MIGT-Lab/respiratory-motion-phantom/docs/images/part_d_chamfer.png

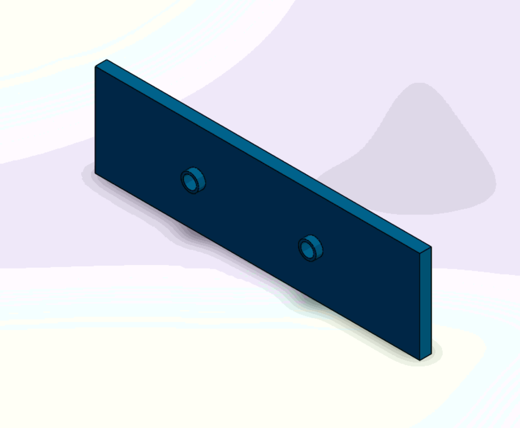
docs/images/part_d_chamfer.png
