MIGT-Lab/respiratory-motion-phantom/hardware/motion-actuator/actuator_b.stl

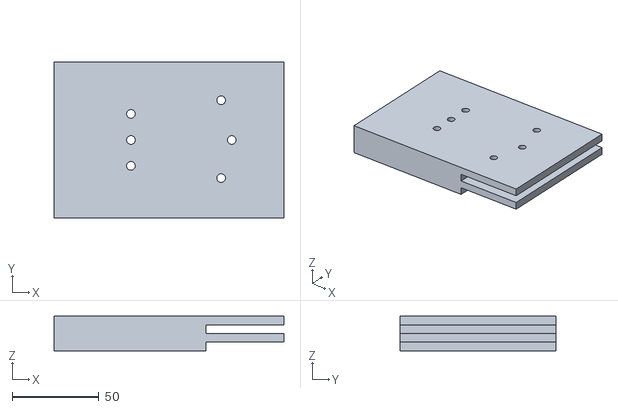
[picture p12: CAD file, 2026-10-25]
hardware/motion-actuator/actuator_b.stl
132.5 x 89.8 x 20.0
