MIGT-Lab/respiratory-motion-phantom/hardware/motion-phantom/back_cover.stl

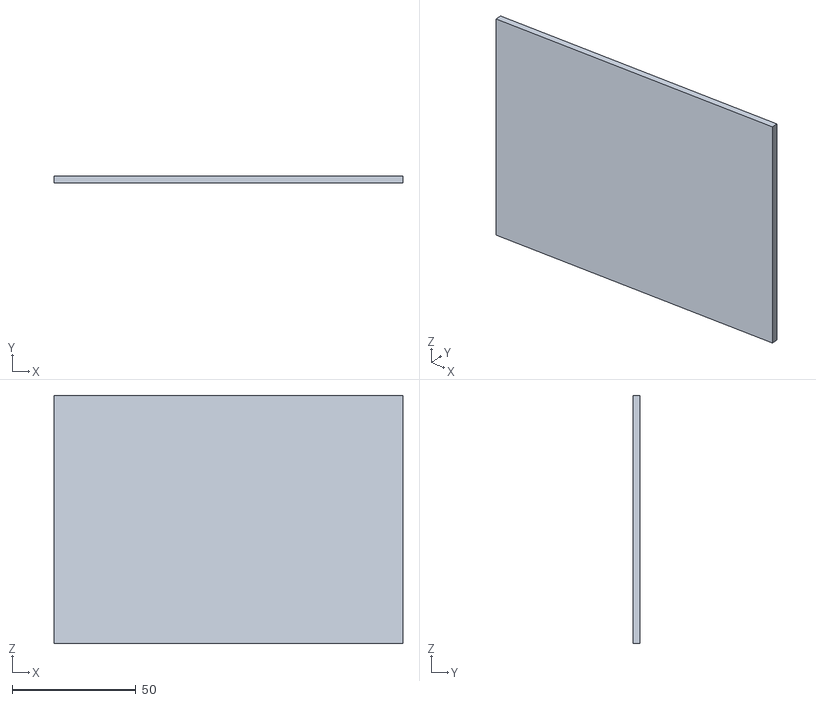
[picture p13: CAD file, 2026-10-25]
hardware/motion-phantom/back_cover.stl
140.8 x 3.00 x 100.2
