MIGT-Lab/respiratory-motion-phantom/hardware/motion-actuator/motor_cover_a.stl

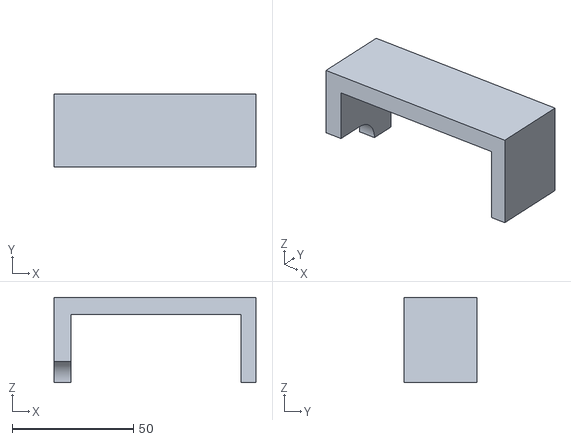
[picture p14: CAD file, 2026-10-25]
hardware/motion-actuator/motor_cover_a.stl
83.4 x 30.0 x 35.1
