MIGT-Lab/respiratory-motion-phantom/hardware/motion-phantom/part_c.stl

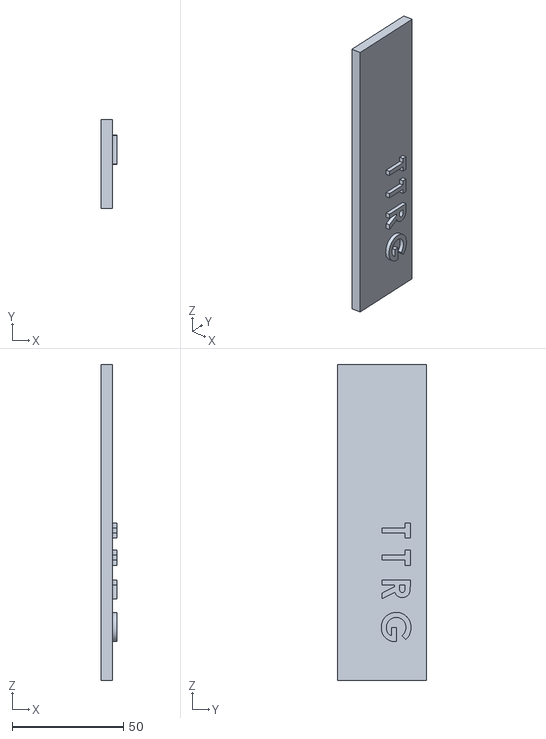
[picture p15: CAD file, 2026-10-25]
hardware/motion-phantom/part_c.stl
7.00 x 40.0 x 142.0
