MIGT-Lab/respiratory-motion-phantom/hardware/motion-actuator/bumper.stl

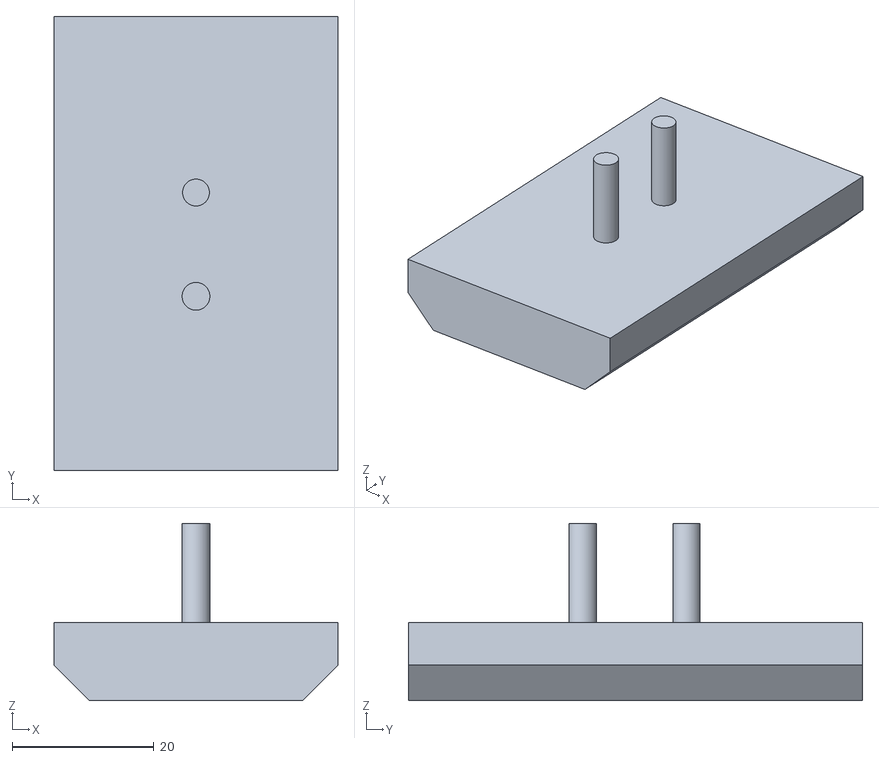
[picture p16: CAD file, 2026-10-25]
hardware/motion-actuator/bumper.stl
40.0 x 64.0 x 25.0
