MIGT-Lab/respiratory-motion-phantom/hardware/motion-phantom/bag_box.stl

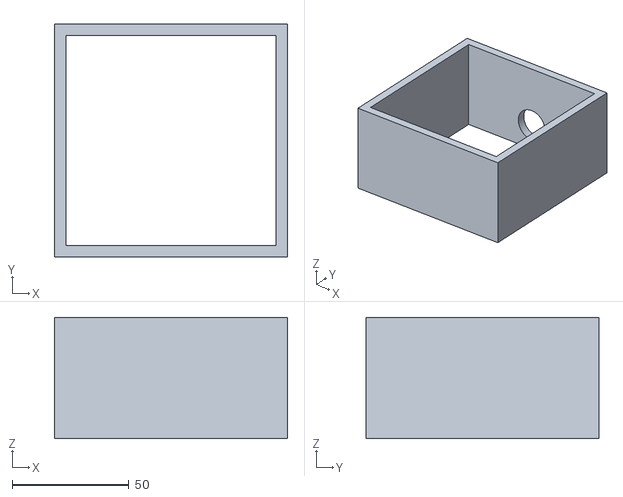
[picture p17: CAD file, 2026-10-25]
hardware/motion-phantom/bag_box.stl
100.0 x 100.0 x 52.0
