MIGT-Lab/respiratory-motion-phantom/hardware/motion-actuator/mcw.stl

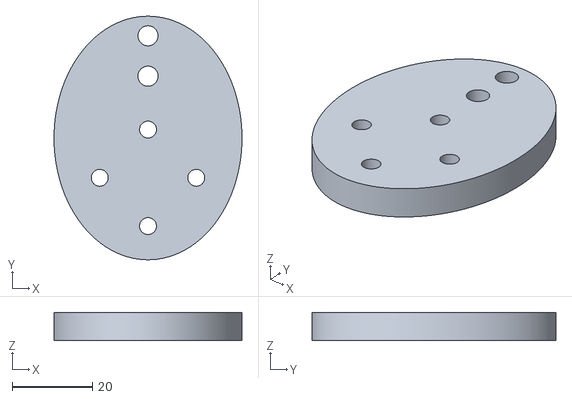
[picture p18: CAD file, 2026-10-25]
hardware/motion-actuator/mcw.stl
46.7 x 60.6 x 7.00
