MIGT-Lab/respiratory-motion-phantom/hardware/motion-phantom/pusher_a.stl

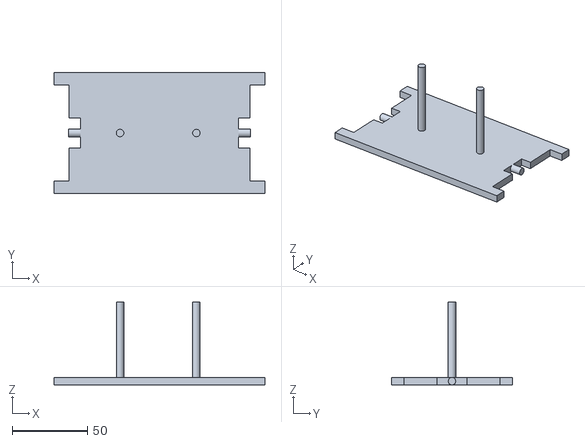
[picture p19: CAD file, 2026-10-25]
hardware/motion-phantom/pusher_a.stl
140.0 x 80.0 x 55.0
