MIGT-Lab/respiratory-motion-phantom/hardware/motion-actuator/piston_holder_b.stl

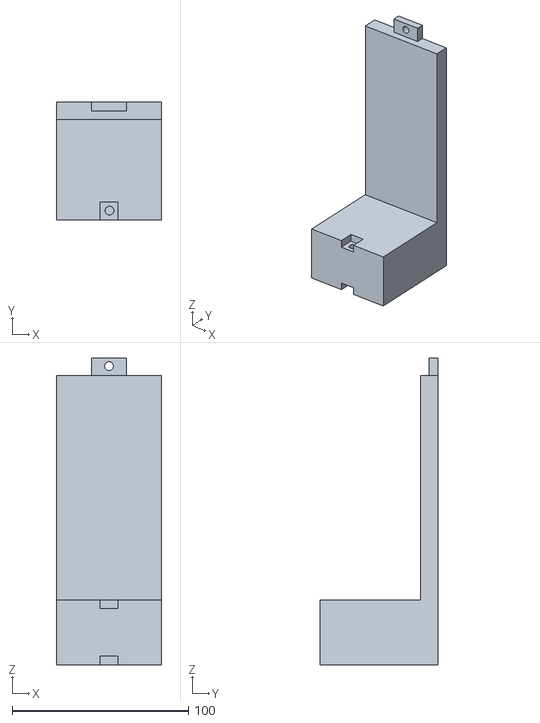
[picture p20: CAD file, 2026-10-25]
hardware/motion-actuator/piston_holder_b.stl
59.4 x 66.9 x 174.4
