MIGT-Lab/respiratory-motion-phantom/hardware/motion-phantom/part_d.stl

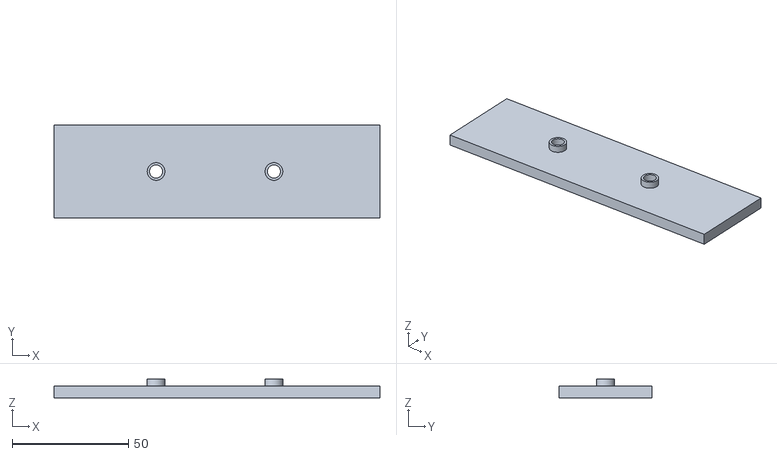
[picture p21: CAD file, 2026-10-25]
hardware/motion-phantom/part_d.stl
140.0 x 40.0 x 8.00
