MIGT-Lab/respiratory-motion-phantom/hardware/motion-phantom/part_b.stl

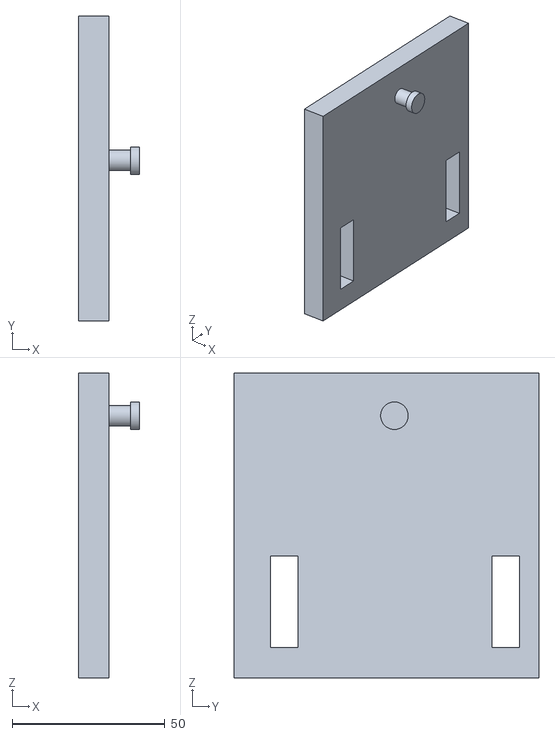
[picture p22: CAD file, 2026-10-25]
hardware/motion-phantom/part_b.stl
20.0 x 100.0 x 100.0
