MIGT-Lab/respiratory-motion-phantom/hardware/motion-actuator/bvm_holder_b.stl

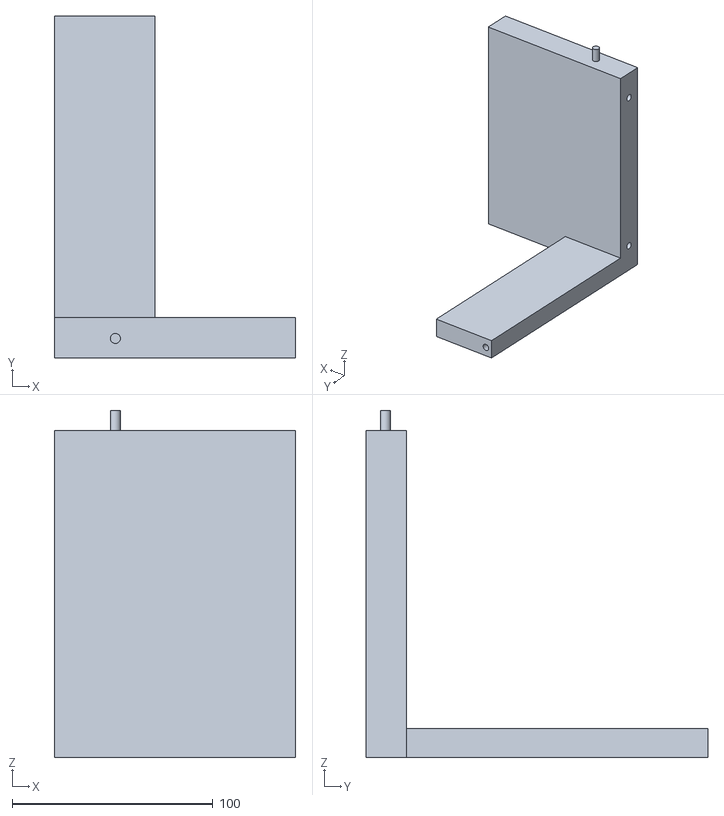
[picture p23: CAD file, 2026-10-25]
hardware/motion-actuator/bvm_holder_b.stl
120.2 x 170.1 x 172.7
