MIGT-Lab/respiratory-motion-phantom/hardware/motion-phantom/pusher_b.stl

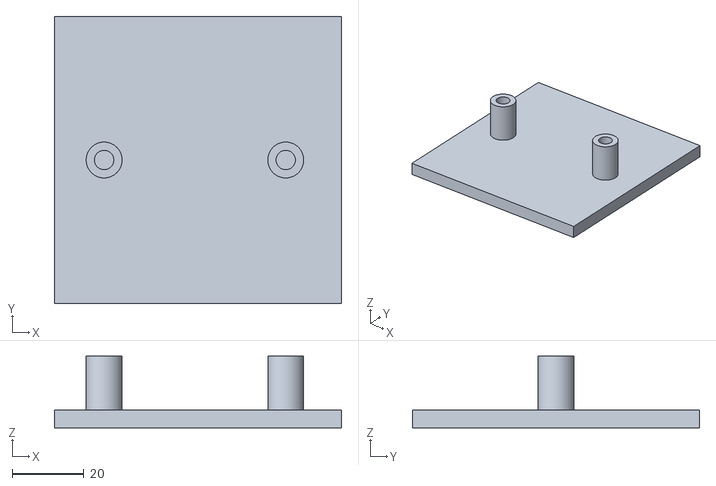
[picture p24: CAD file, 2026-10-25]
hardware/motion-phantom/pusher_b.stl
80.0 x 80.0 x 20.0
