MIGT-Lab/respiratory-motion-phantom/hardware/motion-actuator/piston_holder_c.stl

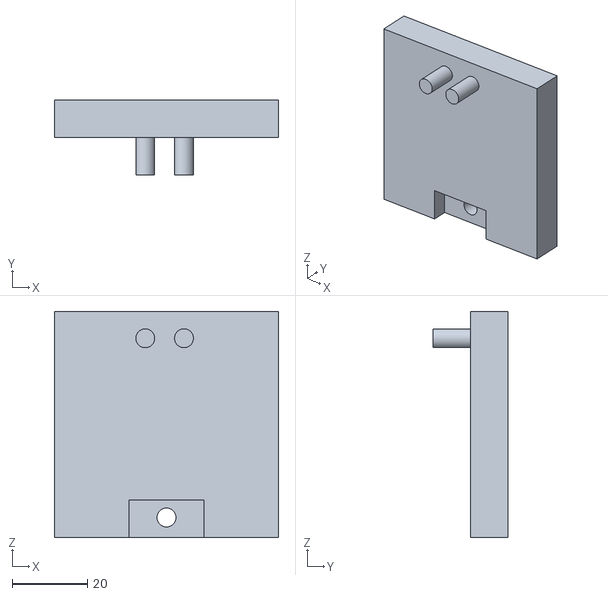
[picture p25: CAD file, 2026-10-25]
hardware/motion-actuator/piston_holder_c.stl
59.4 x 20.0 x 60.0
