MIGT-Lab/respiratory-motion-phantom/hardware/motion-actuator/bar_29mm.stl

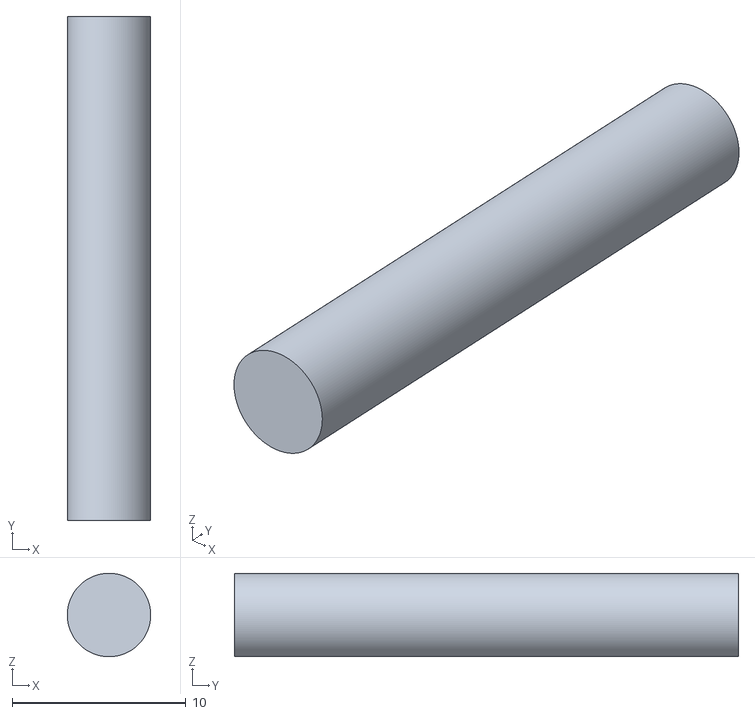
[picture p26: CAD file, 2026-10-25]
hardware/motion-actuator/bar_29mm.stl
4.80 x 29.0 x 4.80
