MIGT-Lab/respiratory-motion-phantom/hardware/motion-actuator/bar_10mm.stl

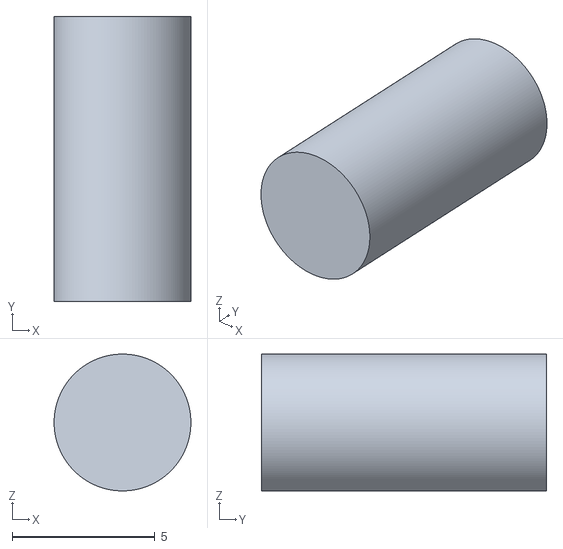
[picture p27: CAD file, 2026-10-25]
hardware/motion-actuator/bar_10mm.stl
4.80 x 10.0 x 4.80
