MIGT-Lab/respiratory-motion-phantom/hardware/motion-actuator/volume_control_20mm.stl

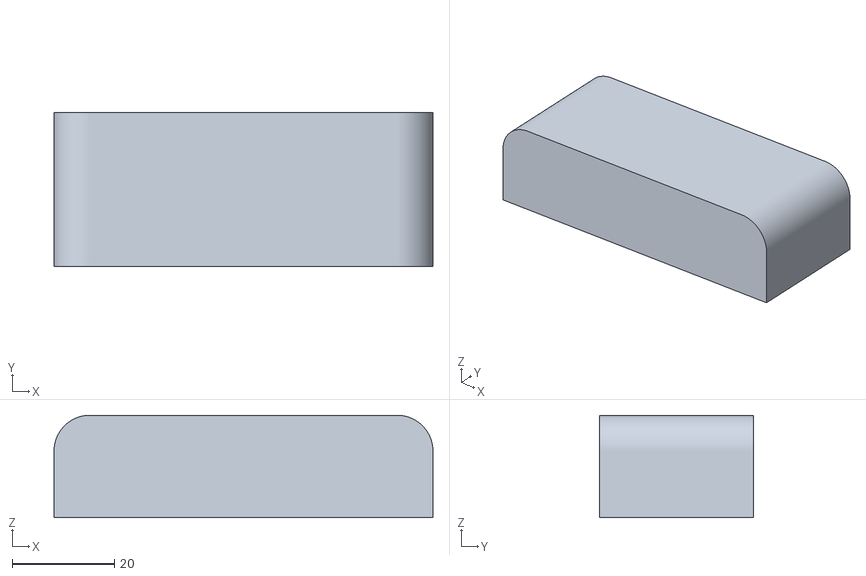
[picture p28: CAD file, 2026-10-25]
hardware/motion-actuator/volume_control_20mm.stl
74.0 x 30.0 x 20.0
