MIGT-Lab/respiratory-motion-phantom/hardware/motion-actuator/volume_control_10mm.stl

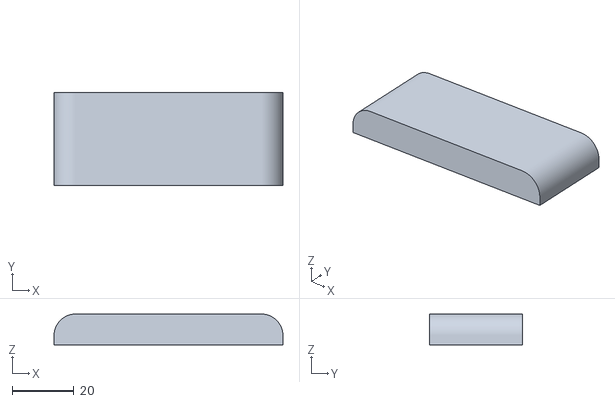
[picture p29: CAD file, 2026-10-25]
hardware/motion-actuator/volume_control_10mm.stl
74.0 x 30.0 x 10.0
