MIGT-Lab/respiratory-motion-phantom/hardware/motion-actuator/volume_control_05mm.stl

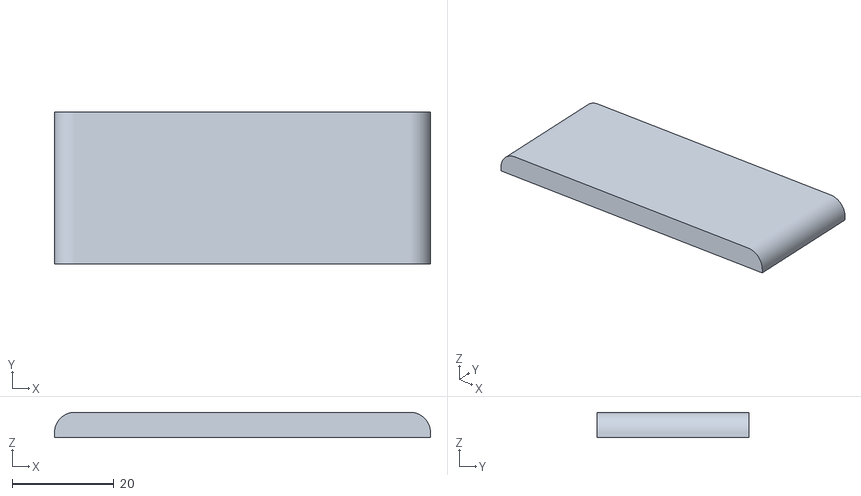
[picture p30: CAD file, 2026-10-25]
hardware/motion-actuator/volume_control_05mm.stl
74.0 x 30.0 x 5.00
