MIGT-Lab/respiratory-motion-phantom/hardware/motion-actuator/piston_holder_a.stl

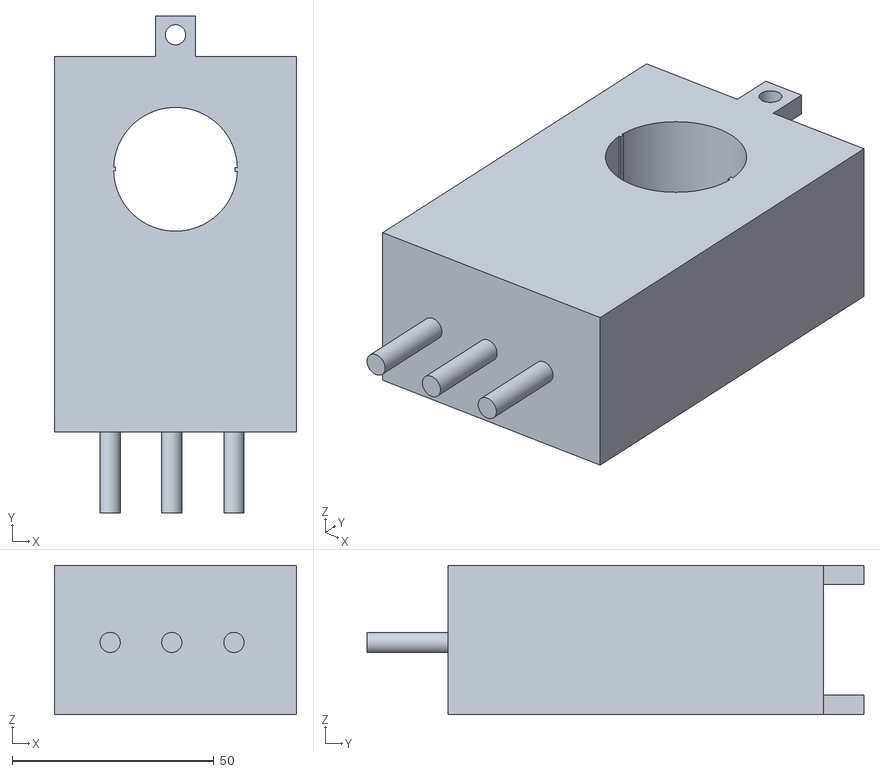
[picture p31: CAD file, 2026-10-25]
hardware/motion-actuator/piston_holder_a.stl
59.9 x 123.0 x 37.0
