MIGT-Lab/respiratory-motion-phantom/hardware/motion-actuator/connecting_rod.stl

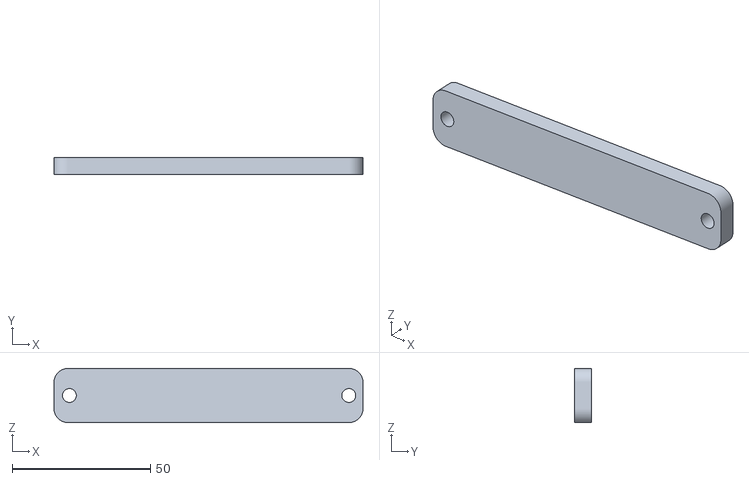
[picture p32: CAD file, 2026-10-25]
hardware/motion-actuator/connecting_rod.stl
111.6 x 6.00 x 19.5
