MIGT-Lab/respiratory-motion-phantom/hardware/motion-actuator/actuator_a.stl

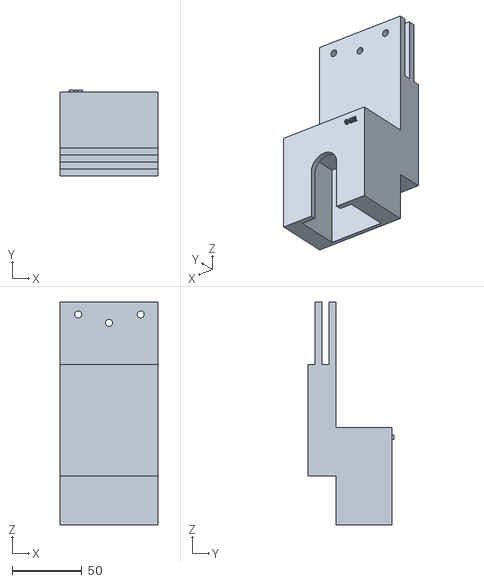
[picture p33: CAD file, 2026-10-25]
hardware/motion-actuator/actuator_a.stl
70.0 x 61.5 x 160.0
