MIGT-Lab/respiratory-motion-phantom/hardware/motion-actuator/bar_20mm.stl

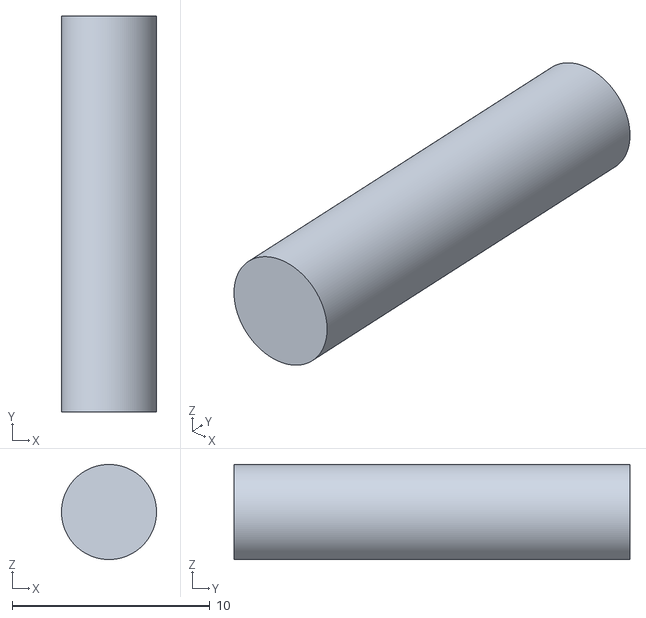
[picture p34: CAD file, 2026-10-25]
hardware/motion-actuator/bar_20mm.stl
4.80 x 20.0 x 4.80
