MIGT-Lab/respiratory-motion-phantom/hardware/motion-actuator/piston.stl

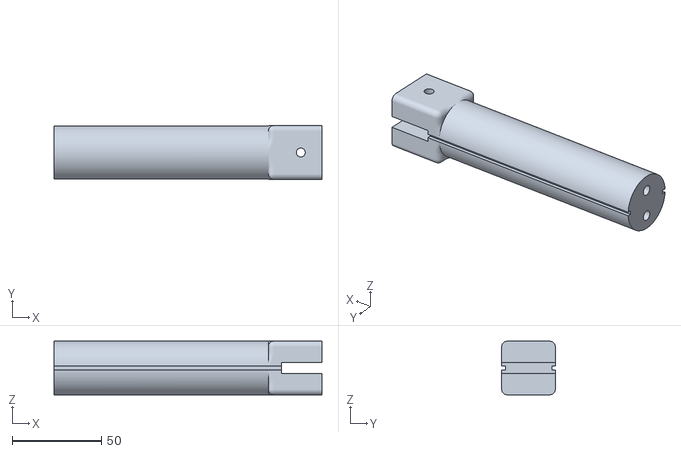
[picture p35: CAD file, 2026-10-25]
hardware/motion-actuator/piston.stl
150.0 x 30.0 x 30.0
