MIGT-Lab/respiratory-motion-phantom/hardware/motion-actuator/bvm_holder_a.stl

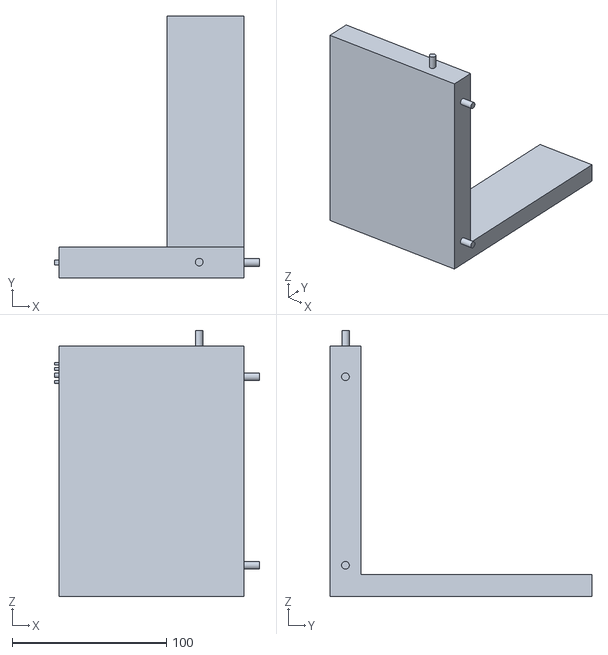
[picture p36: CAD file, 2026-10-25]
hardware/motion-actuator/bvm_holder_a.stl
133.2 x 170.0 x 172.7
