MIGT-Lab/respiratory-motion-phantom/hardware/motion-actuator/bvm_stander.stl

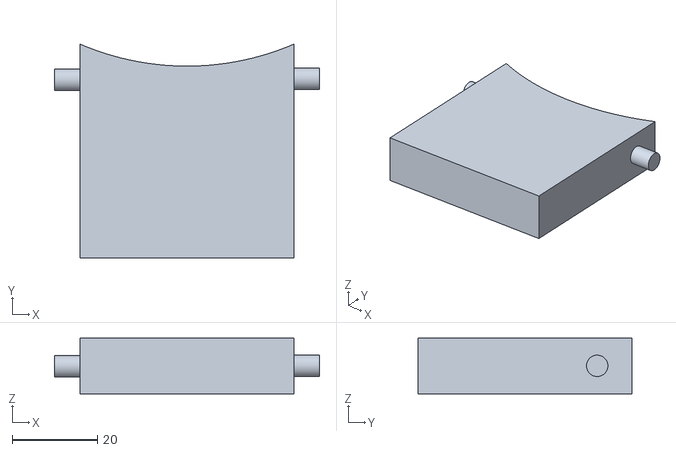
[picture p37: CAD file, 2026-10-25]
hardware/motion-actuator/bvm_stander.stl
62.0 x 50.0 x 13.0
