MIGT-Lab/respiratory-motion-phantom/(list of files, cad)

Other CAD files:
hardware/motion-actuator/motor_cover_b.stl
hardware/motion-phantom/part_a.stl
